whatnick/V9261F_Breakout/docs/current_transformer.png

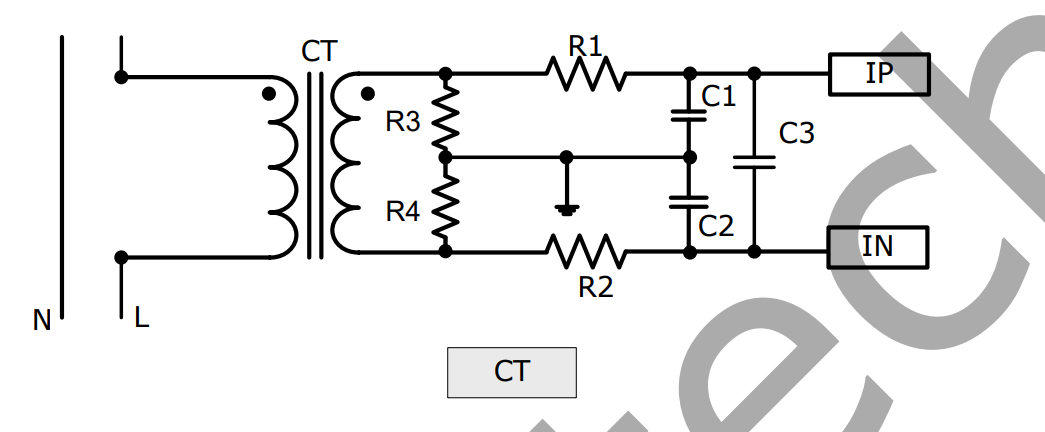
docs/current_transformer.png
