whatnick/V9261F_Breakout/docs/potential_transformer.png

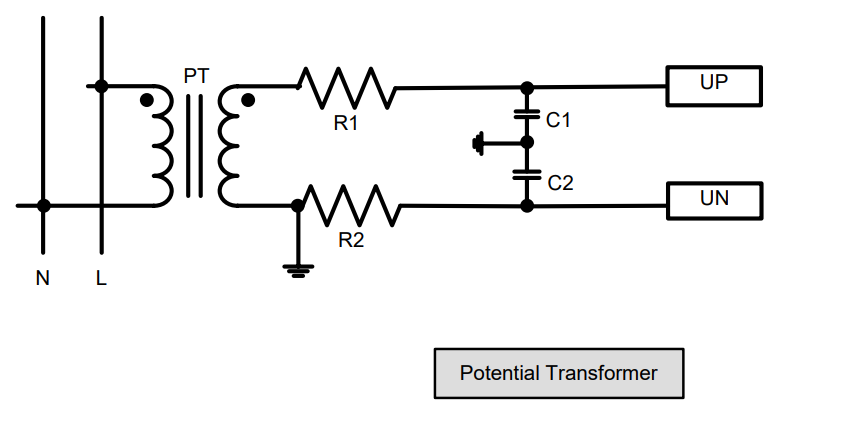
docs/potential_transformer.png
