whatnick/V9261F_Breakout/docs/V9261F_Shunt_Reference.jpg

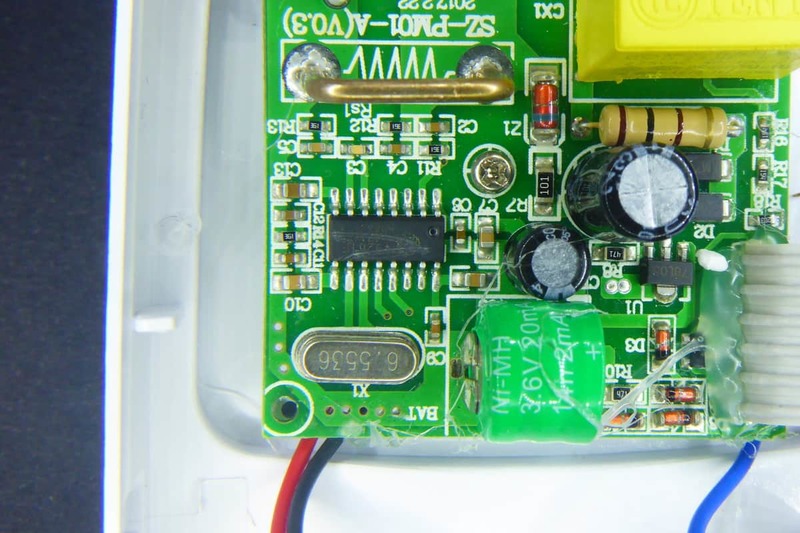
docs/V9261F_Shunt_Reference.jpg
