whatnick/V9261F_Breakout/bom/V9261F_Breakout_Elecrow.xlsx

*Reference | *Manufacturer Part number | *QTY | *Original | Description | Purchase Link
C1, C2, C5, C7 | GMC10X7R104K100NT | 4 |  | 100n | https://www.digikey.com.au/en/products/detail/cal-chip-electronics-inc/GMC10X7R104K100NT/12140453
C3, C4, C6, C8 | C0805C475K8PACTU | 4 |  | 4.7u | https://www.digikey.com.au/en/products/detail/kemet/C0805C475K8PACTU/551599
C10, C11, C12, C13 | CC0603JRX7R9BB333 | 4 |  | 33n | https://www.digikey.com.au/en/products/detail/yageo/CC0603JRX7R9BB333/5883689
C9 | 885012206003 | 1 |  | 100p | https://www.digikey.com.au/en/products/detail/w%C3%BCrth-elektronik/885012206003/5453777
R3, R4, R5, R6 | RR0816P-102-D | 4 |  | 1k | https://www.digikey.com.au/en/products/detail/susumu/RR0816P-102-D/432185
R1, R2 | CPF0603B2R21E1 | 2 |  | 2R2 | https://www.digikey.com.au/en/products/detail/te-connectivity-passive-product/CPF0603B2R21E1/14007137
U1 | V9261F | 1 |  | V9261F | https://www.aliexpress.com/item/1005007455655204.html
Y1 | 830028430 | 1 |  | 6.5536/3.2768 MHz | https://www.digikey.com.au/en/products/detail/w%C3%BCrth-elektronik/830028430/13900474
