whatnick/V9261F_Breakout/(commit log)

2022-10-15 Initial footprints
    [V9261F_Breakout.kicad_pcb, V9261F_Breakout.kicad_sch]
2024-12-22 Add input stage
    [V9261F_Breakout.kicad_pcb, V9261F_Breakout.kicad_sch]
2024-12-23 Add labels and testpoints
    [V9261F_Breakout.kicad_sch]
2024-12-23 Initial routing
    [V9261F_Breakout.kicad_pcb, V9261F_Breakout.kicad_sch]
2024-12-23 Complete values, routing and initial silkscreen
    [V9261F_Breakout.kicad_pcb, V9261F_Breakout.kicad_sch]
2024-12-26 Update PCB component values
    [V9261F_Breakout.kicad_pcb, V9261F_Breakout.kicad_sch]
2025-01-01 Add gerbers and BOM
    [V9261F_Breakout-B_Cu.gbr, V9261F_Breakout-B_Mask.gbr, V9261F_Breakout-B_Paste.gbr, V9261F_Breakout-B_Silkscreen.gbr, V9261F_Breakout-Edge_Cuts.gbr, V9261F_Breakout-F_Cu.gbr, V9261F_Breakout-F_Mask.gbr, V9261F_Breakout-F_Paste.gbr]
